RealCorebb/bbScope/README.md

# bbScope [English](https://github.com/RealCorebb/bbScope/blob/main/README_EN.md "English")



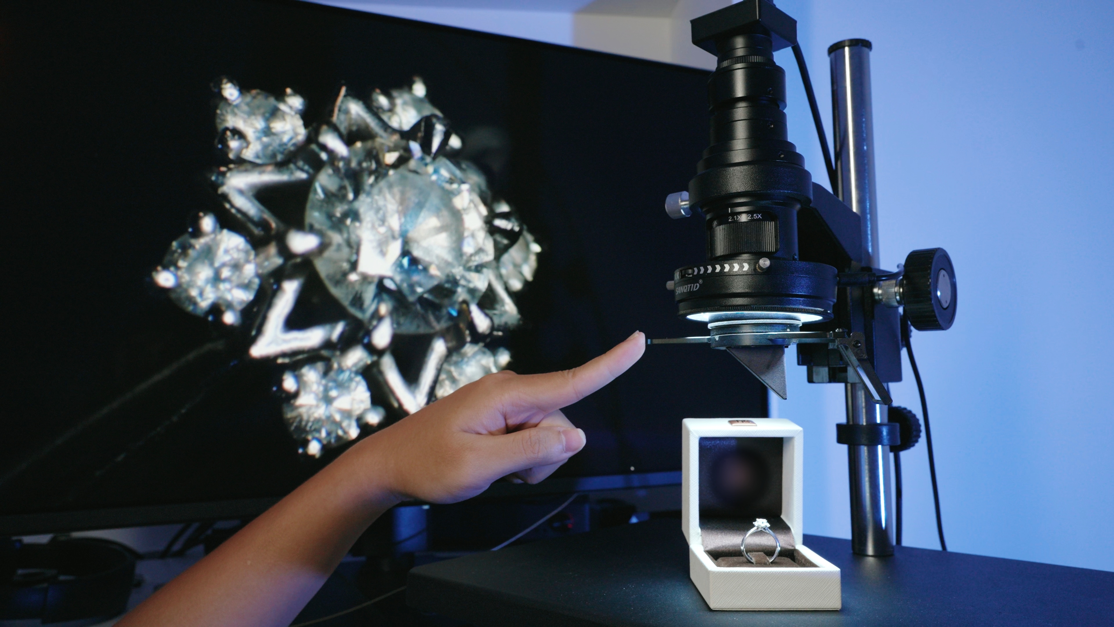
[picture p1: IMG/bbScope.jpg]


## 3D 多视角数码显微镜

很早以前就想拥有数码显微镜，所以我自己制作了一台，并设计了3D旋转模块，实现挺震撼的视觉效果。

### ▶️ 视频（制作过程、效果演示）：[YouTube](https://www.youtube.com/watch?v=Ltk5rLHQRfw "YouTube") ｜ [Bilibili](https://www.bilibili.com/video/BV1Prpb67E8w/ "Bilibili")

😄[爱发电(赞助、本工程的完整Autodesk Fusion(.f3z)、.step格式)](https://afdian.com/a/kuruibb "爱发电(赞助)")   
🧵[Threads](https://www.threads.net/@coreoobb "@coreoobb") @coreoobb  
🐧QQ 群（仅供交流，人满请加Discord）：647186542  
😈Discord 频道：[加入](https://discord.gg/gvbcCtdQrk "加入")   

## 目录结构

```text
CAD/                           # 3D模型
├── rotate.step                # CNC加工，模块旋转本体
├── bot.step                   # CNC加工，模块固定（与旋转体接触）
├── top.stl                    # 3D打印，模块固定（与镜头接触）（光固化打印）
├── Mirror_3Dv2.stl            # 3D打印，反射镜固定 (MJF尼龙打印)
└── prism_cover.stl            # 3D打印，棱镜保护罩（非必须）
bbScope Materials.xlsx         # 物料清单
```

## 说明

该3D模块适用于工作距离100mm（即WD100）的显微镜头，相机可按自行需求选择。  
装配过程需要一定的工具，如橡胶锤敲打定位销、轴承。

## 想购买成品？
现已上架两个SKU：整机、单独3D模块。  
购买方式1：[B站小店](https://mall.bilibili.com/neul-next/detailuniversal/detail.html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) （APP端：B站 —— 酷睿比比 —— 小店）  
购买方式2：[闲鱼](https://www.goofish.com/item?spm=a21107h.42831410.0.0.44386a73POyE3G&id=1091217113989&categoryId=0) (APP端：搜“酷睿比比” 鱼小铺)  
购买方式3：[淘宝](https://item.taobao.com/item.htm?ft=t&id=1093202626603&spm=a21dvs.23580594.0.0.37d8645eHhE7ZF) (APP端：搜“酷睿比比” 店铺)

## 安装步骤

1. 将多颗定位销敲击塞入 `rotate.step` 对应孔位
2. 将多颗磁铁以一致的方向通过 T9000 胶水固定在 `rotate.step` 对应孔位
3. 将凹透镜用 T9000 胶水固定在 `rotate.step` 的圆心位置
4. 将 25×25×25mm 反射棱镜用 T9000 胶水固定在凹透镜下方的位置
5. 用 T9000 胶水将棱镜保护罩黏在反射棱镜上（非必须）
6. 将轴承敲进 `bot.step` 中，可用直径小于轴承外径的软垫放在中心，确保轴承敲进最深处
7. 将多颗磁铁以一致的反方向通过 T9000 胶水固定在 `bot.step` 对应孔位
8. `top.stl` 底部涂抹 T9000 胶水后，将 `bot.step` 连同轴承一起固定住
9. 将偏振片用 T9000 胶水黏在 `top.stl` 内部
10. 将 `top.stl` 顺着镜头内螺纹扭进去卡住
11. 将 `rotate.step` 通过磁吸卡进 `bot.step` 和 `top.stl` 整体的下方
12. 将 37×37×1mm 反射镜卡入 `Mirror_3Dv2.stl`
13. 将 `Mirror_3Dv2.stl` 通过两颗 M2 螺丝锁在 `rotate.step` 末端，另用两颗 M2 螺丝固定反射镜俯仰角度
14. 微调四颗 M2 螺丝，调整反射镜位置、俯仰角度、左右旋转角度，使同心度尽可能高

## 开源协议

本项目采用 **[CC BY-NC 4.0 (知识共享 署名-非商业性使用 4.0 国际许可协议)](LICENSE)** 开源。

**简要说明：**
- **自由共享与修改**：您可以在非商业用途的前提下，自由分享、传播以及修改本项目的内容与文件。
- **署名要求 (Attribution)**：使用或二次创作时必须保留原作者署名（酷睿比比 / RealCorebb），并标明是否对原始工程做出了修改。
- **禁止商业用途 (Non-Commercial)**：**本项目及其衍生作品严禁用于任何商业营利目的**。未经授权，禁止将本项目的 3D 打印件、CNC 加工件、成品整机或衍生设计进行商业销售。
- 完整法律条款请参阅 [LICENSE](LICENSE) 文件及 [Creative Commons 官方条款](https://creativecommons.org/licenses/by-nc/4.0/deed.zh-hans)。
