RealCorebb/bbScope/CAD/top.stl

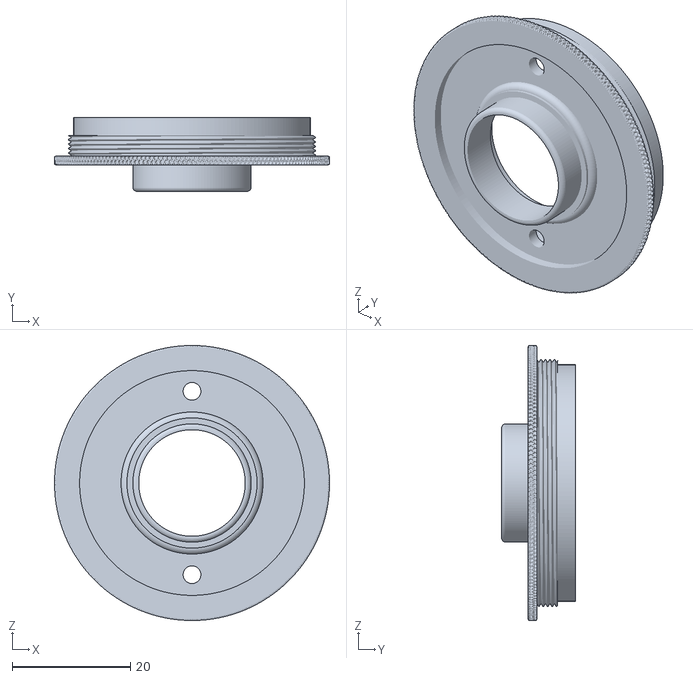
[picture p2: CAD file, 2026-10-09]
CAD/top.stl
46.5 x 12.5 x 46.5
