RealCorebb/bbScope/CAD/Mirror_3Dv2.stl

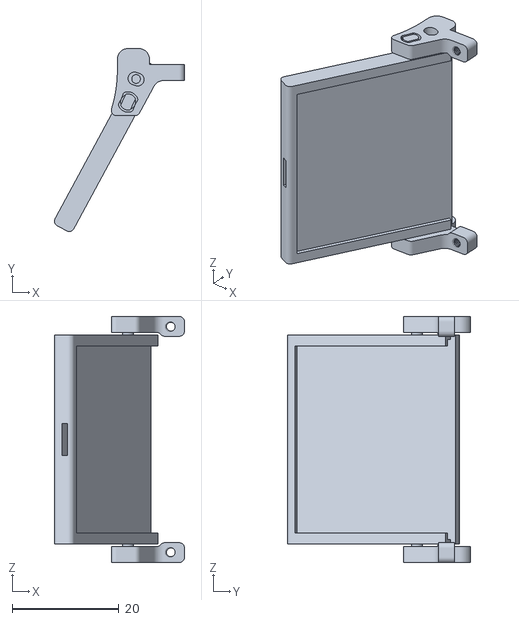
[picture p3: CAD file, 2026-10-09]
CAD/Mirror_3Dv2.stl
24.3 x 34.2 x 46.0
