RealCorebb/bbScope/CAD/prism_cover.stl

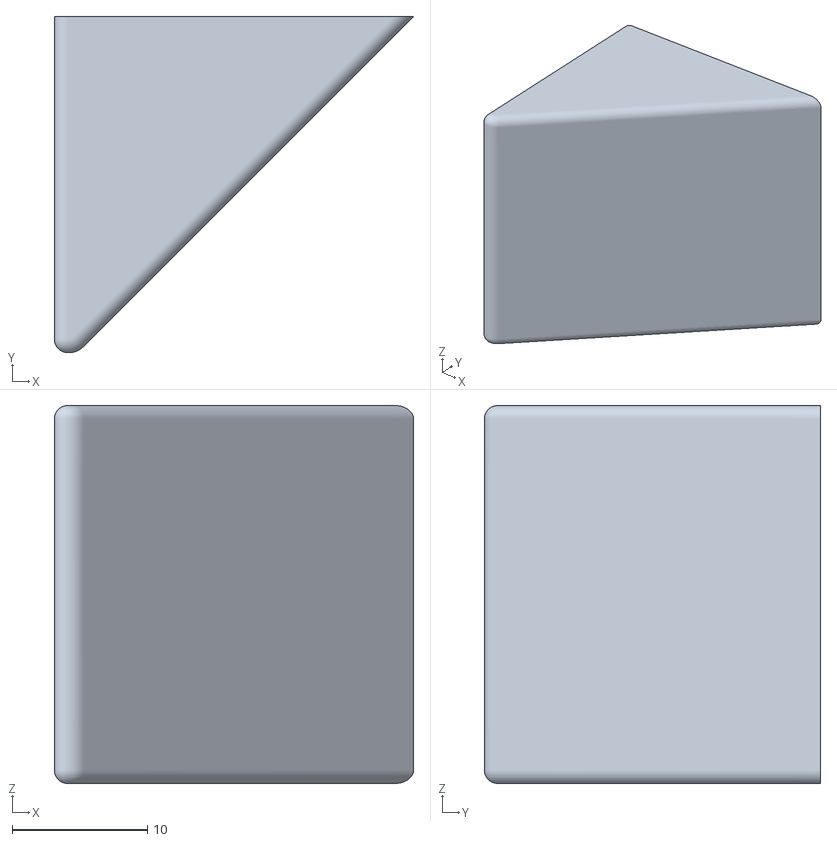
[picture p4: CAD file, 2026-10-09]
CAD/prism_cover.stl
26.6 x 24.9 x 28.0
