RealCorebb/bbScope/CAD/bot.step

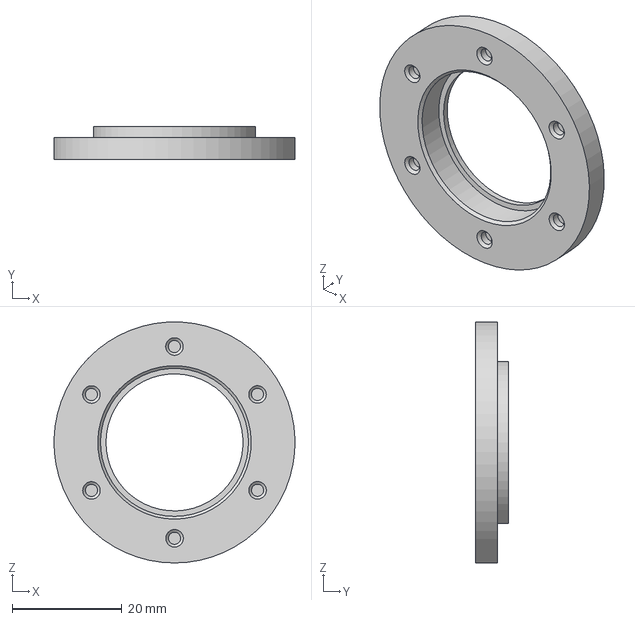
[picture p5: CAD file, 2026-10-09]
CAD/bot.step
44.0 x 6.00 x 44.0 mm
