RealCorebb/bbScope/CAD/rotate.step

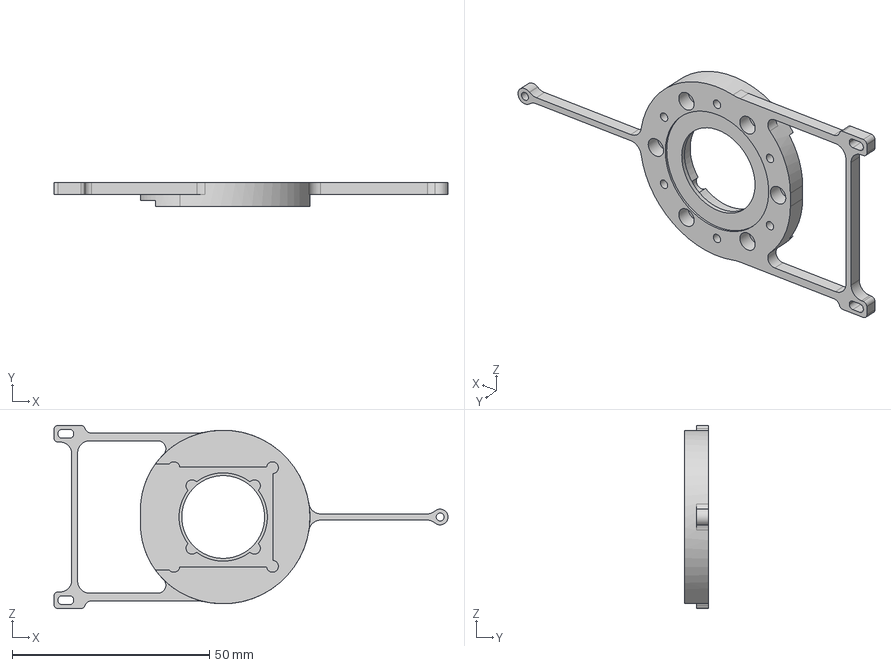
[picture p6: CAD file, 2026-10-09]
CAD/rotate.step
99.9 x 6.00 x 46.4 mm
