RealCorebb/bbScope/(commit log)

2026-10-10 Update bom and readme
    [bbScope Materials.xlsx]
2026-11-02 Revise assembly instructions in README.md
    Reorganize assembly steps for clarity and consistency.
2026-11-02 Revise README with current sales and assembly steps
    Updated assembly instructions and purchasing information.
